SouprP/pico-plc/hardware/rp2350_automation_board.kicad_pcb

## KiCad design hardware/rp2350_automation_board.kicad_pcb (2025-12-06)

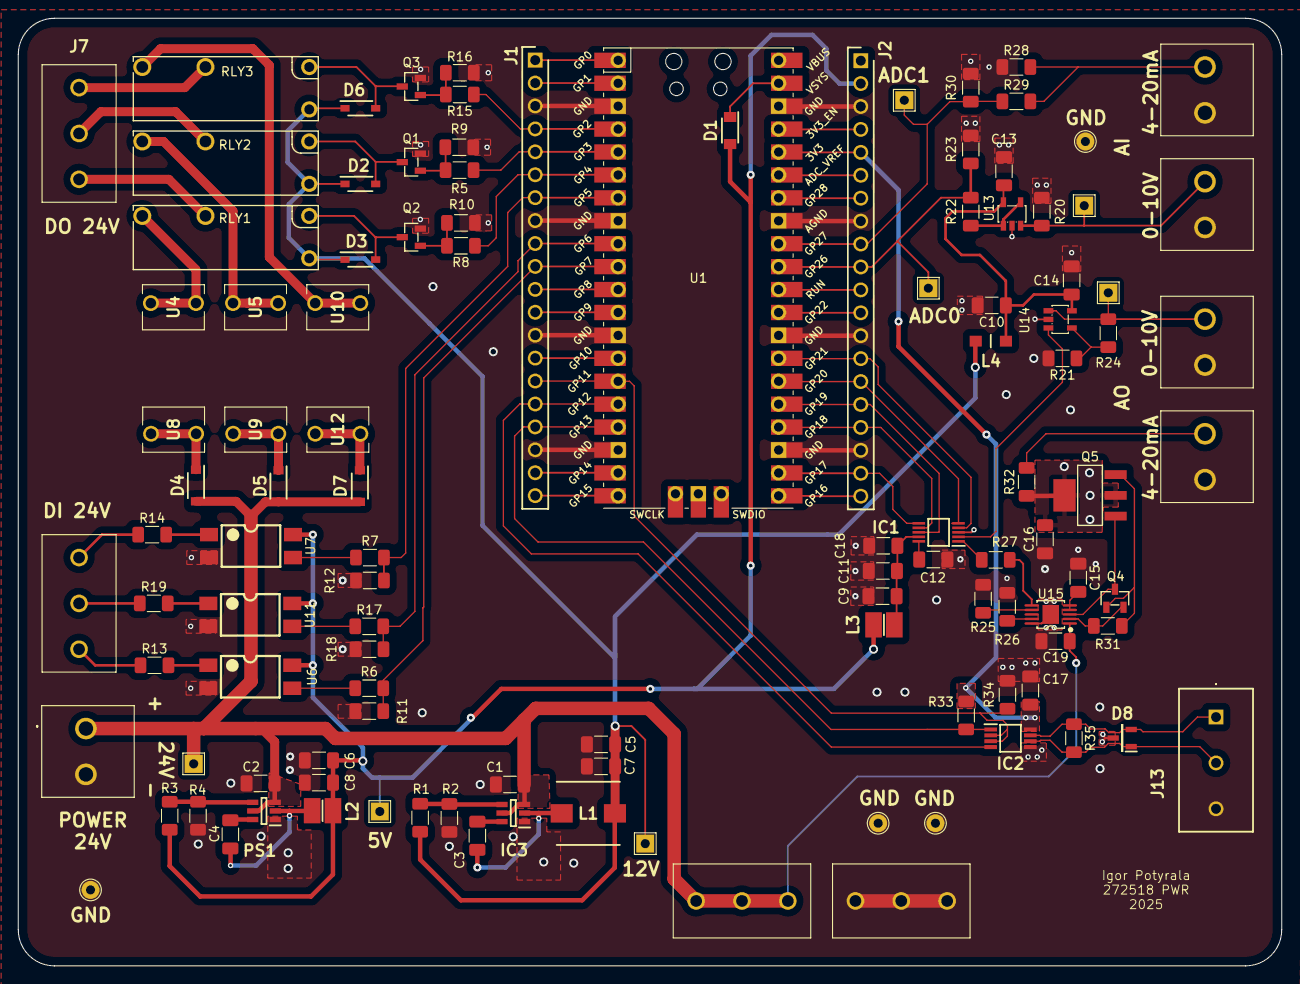
[picture p1: board rp2350_automation_board.kicad_pcb from above]

Board: 2 copper layers, 140.0 x 105.0 mm, 114 parts (0 on the bottom side), 86 nets.

Parts:
C1, C2: 2.2uF; C_1206_3216Metric_Pad1.33x1.80mm_HandSolder
C3, C4, C13, C14, C17, C19: 0.1uF; C_1206_3216Metric_Pad1.33x1.80mm_HandSolder
C5, C7: 22uF; C_1206_3216Metric_Pad1.33x1.80mm_HandSolder
C6, C8, C9, C10: 10uF; C_1206_3216Metric_Pad1.33x1.80mm_HandSolder
C11: 1uF; C_1206_3216Metric_Pad1.33x1.80mm_HandSolder
C12: 150nF; C_1206_3216Metric_Pad1.33x1.80mm_HandSolder
C15: 470nF; C_1206_3216Metric_Pad1.33x1.80mm_HandSolder
C16: 10nF; C_1206_3216Metric_Pad1.33x1.80mm_HandSolder
C18: 1nF; C_1206_3216Metric_Pad1.33x1.80mm_HandSolder
D1: MBR230S1F-7; SODFL3518X115N
D2, D3, D6: 1N4148W; SODFL3816X120N
D4, D5, D7: 1N4007W-T; SODFL3818X130N
D8: CDSOT23-SM712; SOT95P230X117-3N
IC1: DAC7562SDGSR; SOP50P490X110-10N
IC2: SN65HVD75DGKR; SOP65P490X110-8N
IC3: LMR51420XFDDCR; SOT95P280X110-6N
J1, J2: PH1-20-UA; HDRV20W64P0X254_1X20_5080X249X886P
J3, J4, J7, J14: TB006-508-03BE; TB00650803BE
J5, J9, J10, J11, J12: TB007-508-02BE; TB00750802BE
J13: 39880-0303; 398800303
L1: 22uH; INDPM7070X480N
L2, L3: 4.7uH; INDC3225X120N
L4: 1uH; LQM31PN1R0M00L
PS1: LMR51420YFDDCR; SOT95P280X110-6N
Q1, Q2, Q3: 2N7002; SOT-23-3_L2.9-W1.3-P1.90-LS2.4-BR
Q4: MMBT2907ALT1G; SOT-23-3_L2.9-W1.3-P1.90-LS2.4-BR
Q5: BSP171PH6327XTSA1; SOT-223-4_L6.5-W3.5-P2.30-LS7.0-BR
R1, R3, R20: 100k; R_1206_3216Metric_Pad1.30x1.75mm_HandSolder
R2: 5.23k; R_1206_3216Metric_Pad1.30x1.75mm_HandSolder
R4: 13.7k; R_1206_3216Metric_Pad1.30x1.75mm_HandSolder
R5, R8, R15: 330; R_1206_3216Metric_Pad1.30x1.75mm_HandSolder
R6, R7, R9, R10, R16, R17, R21, R26, R33, R34: 10k; R_1206_3216Metric_Pad1.30x1.75mm_HandSolder
R11, R12, R18: 20k; R_1206_3216Metric_Pad1.30x1.75mm_HandSolder
R13, R14, R19: 3.3k; R_1206_3216Metric_Pad1.30x1.75mm_HandSolder
R22: 56k; R_1206_3216Metric_Pad1.30x1.75mm_HandSolder
R23: 24k; R_1206_3216Metric_Pad1.30x1.75mm_HandSolder
R24: 30k; R_1206_3216Metric_Pad1.30x1.75mm_HandSolder
R25: 1.25k; R_1206_3216Metric_Pad1.30x1.75mm_HandSolder
R27: 0R; R_1206_3216Metric_Pad1.30x1.75mm_HandSolder
R28: 250R; R_1206_3216Metric_Pad1.30x1.75mm_HandSolder
R29: 22k; R_1206_3216Metric_Pad1.30x1.75mm_HandSolder
R30: 33k; R_1206_3216Metric_Pad1.30x1.75mm_HandSolder
R31, R32: 15; R_1206_3216Metric_Pad1.30x1.75mm_HandSolder
R35: 120R; R_1206_3216Metric_Pad1.30x1.75mm_HandSolder
RLY1, RLY2, RLY3: G5NB-1A-E-DC12; RELAY-TH_G5NB-1A-E-DCXX
TP1: TP_+12V; TestPoint_THTPad_2.0x2.0mm_Drill1.0mm
TP2, TP4, TP6, TP7: GND_TP; TestPoint_THTPad_D2.0mm_Drill1.0mm
TP3: TP_+5V; TestPoint_THTPad_2.0x2.0mm_Drill1.0mm
TP5: TP_+24V; TestPoint_THTPad_2.0x2.0mm_Drill1.0mm
TP8: TP_AO_0-10V; TestPoint_THTPad_2.0x2.0mm_Drill1.0mm
TP9: TP_ADC0; TestPoint_THTPad_2.0x2.0mm_Drill1.0mm
TP10: TP_AI_0-10V; TestPoint_THTPad_2.0x2.0mm_Drill1.0mm
TP11: TP_ADC1; TestPoint_THTPad_2.0x2.0mm_Drill1.0mm
U1: Pico; RPi_Pico_SMD_TH
U4, U5, U8, U9, U10, U12: FUSE_C; 01110501Z
U6, U7, U11: LTV-814S-TA1; SMD-4_L4.6-W6.5-P2.54-LS10.2-BL
U13, U14: TLV9301IDBVR; SOT-23-5_L3.0-W1.7-P0.95-LS2.8-BR
U15: XTR111AIDGQR; MSOP-10_L3.0-W3.0-P0.50-LS5.0-BL-EP

Connections:
5V_SW: C4.2, L2.1, PS1.2 (SW)
12V_SW: C3.2, IC3.2 (SW), L1.1
+3V3: C17.1, IC2.8 (VCC), J2.5, R33.1, U1.36 (3V3)
+5V: C6.1, C8.1, D1.2 (A), J2.2, L2.2, L3.1, R3.1, TP3.1, U6.4, U7.4, U11.4
+12V: C5.1, C7.1, D2.1 (K), D3.1 (K), D6.1 (K), L1.2, L4.1, R1.1, RLY1.4, RLY2.4, RLY3.4, TP1.1
+12V_LPF_OP: C10.1, C13.1, C14.1, L4.2, U13.5 (V+), U14.5 (V+)
+24V: C1.2, C2.2, C19.2, D4.2 (A), D5.2 (A), D7.2 (A), IC3.3 (VIN), IC3.5 (EN), J3.1, J3.2, J3.3, J5.1, PS1.3 (VIN), PS1.5 (EN), TP5.1, U15.1 (VSP)
/Analog IO/AI_0-10V_IN: J9.1, R20.2, TP10.1, U13.3 (+IN)
/Analog IO/AI_4-20mA_IN: J11.1, R28.2, R29.2
/Analog IO/AO_0-10V: J10.1, R24.1, TP8.1, U14.1 (OUT)
/Analog IO/AO_4-20mA: J12.1, R32.2
/Analog IO/DAC_0-10V: IC1.2 (VOUT_B), U14.3 (+IN)
/Analog IO/DAC_4-20mA: IC1.1 (VOUT_A), R27.2
/Digital IO/DI_1: J14.1, R13.1
/Digital IO/DI_2: J14.2, R19.1
/Digital IO/DI_3: J14.3, R14.1
/Digital IO/DO_1: J7.1, RLY1.2
/Digital IO/DO_2: J7.2, RLY2.2
/Digital IO/DO_3: J7.3, RLY3.2
/RS-485/RS485+: D8.2, IC2.7 (B), J13.1, R35.1
/RS-485/RS485-: D8.1, IC2.6 (A), J13.2, R35.2
ADC0: J2.10, R22.1, R23.2, TP9.1, U1.31 (GPIO26_ADC0)
ADC1: J2.9, R29.1, R30.2, TP11.1, U1.32 (GPIO27_ADC1)
DAC_LDAC: IC1.4 (~LDAC), J2.14, U1.27 (GPIO21)
DAC_RESET: IC1.5 (~CLR), J2.15, U1.26 (GPIO20)
DIN_1: J1.7, R7.2, R12.2, U1.7 (GPIO5)
DIN_2: J1.9, R17.2, R18.2, U1.9 (GPIO6)
DIN_3: J1.10, R6.2, R11.2, U1.10 (GPIO7)
DOUT_1: J1.4, R15.1, U1.4 (GPIO2)
DOUT_2: J1.5, R5.1, U1.5 (GPIO3)
DOUT_3: J1.6, R8.1, U1.6 (GPIO4)
GND: C1.1, C2.1, C5.2, C6.2, C7.2, C8.2, C9.2, C10.2, C11.1, C12.2, C13.2, C14.2, C15.1, C16.1, C17.2, C18.1, C19.1, D8.3, IC1.3 (GND), IC2.5 (GND), IC3.1 (GND), J1.3, J1.8, J1.13, J1.18, J2.3, J2.8, J2.13, J2.18, J4.1, J4.2, J4.3, J5.2, J9.2, J10.2, J11.2, J12.2, J13.3, PS1.1 (GND), Q1.2 (S), Q2.2 (S), Q3.2 (S), R2.2, R4.2, R9.1, R10.1, R11.1, R12.1, R16.1, R18.1, R20.1, R21.2, R23.1, R25.2, R26.2, R28.1, R30.1, R34.2, TP2.1, TP4.1, TP6.1, TP7.1, U1.3 (GND), U1.8 (GND), U1.13 (GND), U1.18 (GND), U1.23 (GND), U1.28 (GND), U1.33 (AGND), U1.38 (GND), U6.2, U7.2, U11.2, U13.2 (V-), U14.2 (V-), U15.10 (GND), U15.11 (PAD)
unnamed: C16.2, Q5.2 (D), Q5.4 (D), R32.1
unnamed: D1.1 (K), U1.39 (VSYS)
unnamed: D2.2 (A), Q1.3 (D), RLY2.1
unnamed: D3.2 (A), Q2.3 (D), RLY1.1
unnamed: D4.1 (K), U8.1, U8.2
unnamed: D5.1 (K), U9.1, U9.2
unnamed: D6.2 (A), Q3.3 (D), RLY3.1
unnamed: D7.1 (K), U12.1, U12.2
unnamed: C9.1, C11.2, C18.2, IC1.9 (AVDD), L3.2
unnamed: C12.1, IC1.10 (VREFIN/VREFOUT)
unnamed: C3.1, IC3.6 (CB)
unnamed: IC3.4 (FB), R1.2, R2.1
unnamed: C4.1, PS1.6 (CB)
unnamed: PS1.4 (FB), R3.2, R4.1
unnamed: Q1.1 (G), R5.2, R9.2
unnamed: Q2.1 (G), R8.2, R10.2
unnamed: Q3.1 (G), R15.2, R16.2
unnamed: Q4.1 (B), Q5.3 (S), R31.1
unnamed: Q4.3 (C), Q5.1 (G), U15.3 (VG)
unnamed: Q4.2 (E), R31.2, U15.2 (IS)
unnamed: R6.1, U6.3
unnamed: R7.1, U7.3
unnamed: R13.2, U6.1
unnamed: R14.2, U7.1
unnamed: R17.1, U11.3
unnamed: R19.2, U11.1
unnamed: RLY1.3, U4.1, U4.2
unnamed: RLY2.3, U5.1, U5.2
unnamed: RLY3.3, U10.1, U10.2
unnamed: J2.4, U1.37 (3V3_EN)
unnamed: J2.6, U1.35 (ADC_VREF)
unnamed: J1.1, U1.1 (GPIO0)
unnamed: J1.2, U1.2 (GPIO1)
unnamed: J1.11, U1.11 (GPIO8)
unnamed: J1.12, U1.12 (GPIO9)
unnamed: J1.14, U1.14 (GPIO10)
unnamed: J1.19, U1.19 (GPIO14)
unnamed: J1.20, U1.20 (GPIO15)
unnamed: J2.12, U1.29 (GPIO22)
unnamed: J2.7, U1.34 (GPIO28_ADC2)
unnamed: J2.11, U1.30 (RUN)
unnamed: R22.2, U13.1 (OUT), U13.4 (-IN)
unnamed: R21.1, R24.2, U14.4 (-IN)
unnamed: R26.1, U15.9 (OD)
unnamed: C15.2, U15.4 (REGS), U15.5 (REGF)
unnamed: R25.1, U15.7 (SET)
unnamed: R27.1, U15.6 (VIN)
RS485_MODE: IC2.2 (~RE), IC2.3 (DE), J1.15, R34.1, U1.15 (GPIO11)
SPI0_CS: IC1.6 (~SYNC), J2.19, U1.22 (GPIO17)
SPI0_MISO: J2.20, U1.21 (GPIO16)
SPI0_MOSI: IC1.8 (DIN), J2.16, U1.25 (GPIO19)
SPI0_SCK: IC1.7 (SCLK), J2.17, U1.24 (GPIO18)
UART_RX: IC2.1 (R), J1.17, R33.2, U1.17 (GPIO13)
UART_TX: IC2.4 (D), J1.16, U1.16 (GPIO12)
