SouprP/pico-plc/(commit log)

2025-10-10 Modbus frame
2025-11-24 4-20mA start and PWM as DAC
    [aio.kicad_sch]
2025-11-25 XTR117 Output
    [aio.kicad_sch, mcu.kicad_sch, power.kicad_sch, rp2350_automation_board.kicad_pcb]
2025-11-27 Almost everything
    [aio.kicad_sch, io.kicad_sch, mcu.kicad_sch, power.kicad_sch, rp2350_automation_board.kicad_pcb, rs485.kicad_sch]
2025-12-01 Board complete
    [aio.kicad_sch, io.kicad_sch, mcu.kicad_sch, power.kicad_sch, rp2350_automation_board.kicad_pcb, rp2350_automation_board.kicad_sch, rs485.kicad_sch]
2025-12-01 LDAC added
    [aio.kicad_sch, rp2350_automation_board.kicad_pcb, rp2350_automation_board.kicad_sch]
2025-12-06 Modbus, small schematic changes
    [aio.kicad_sch, io.kicad_sch, power.kicad_sch, rp2350_automation_board.kicad_pcb, rp2350_automation_board.kicad_sch, rs485.kicad_sch]
2025-12-08 Modbus library done
    [aio.kicad_sch, power.kicad_sch]
2025-12-08 UART parity and better timing handling
    [aio.kicad_sch, io.kicad_sch, power.kicad_sch, rp2350_automation_board.kicad_sch, rs485.kicad_sch]
